Changes729/Hands-clothes/README.md

KHub 黑客松 3D 打印手部护具赛题成果

- 赛题项目：https://github.com/Amasun93/open-hand-aid
- 黑客松总结：[KHub 黑客松总结](./doc/hackthon/KHub手部辅具说明.md)

许多资料都在社区里，不适合放入 Github 代码仓库。如果有兴趣请联系 Khub 官方了解更多信息。

工程使用 FreeCAD 进行设计。
