Changes729/Hands-clothes/doc/understand/对比图A.jpg

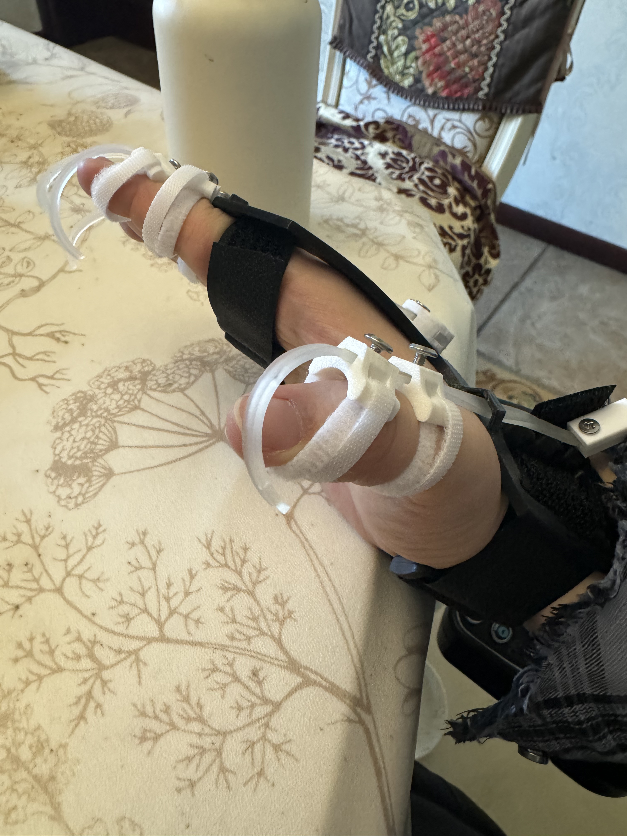
doc/understand/对比图A.jpg
