Changes729/Hands-clothes/doc/understand/对比图B.jpg

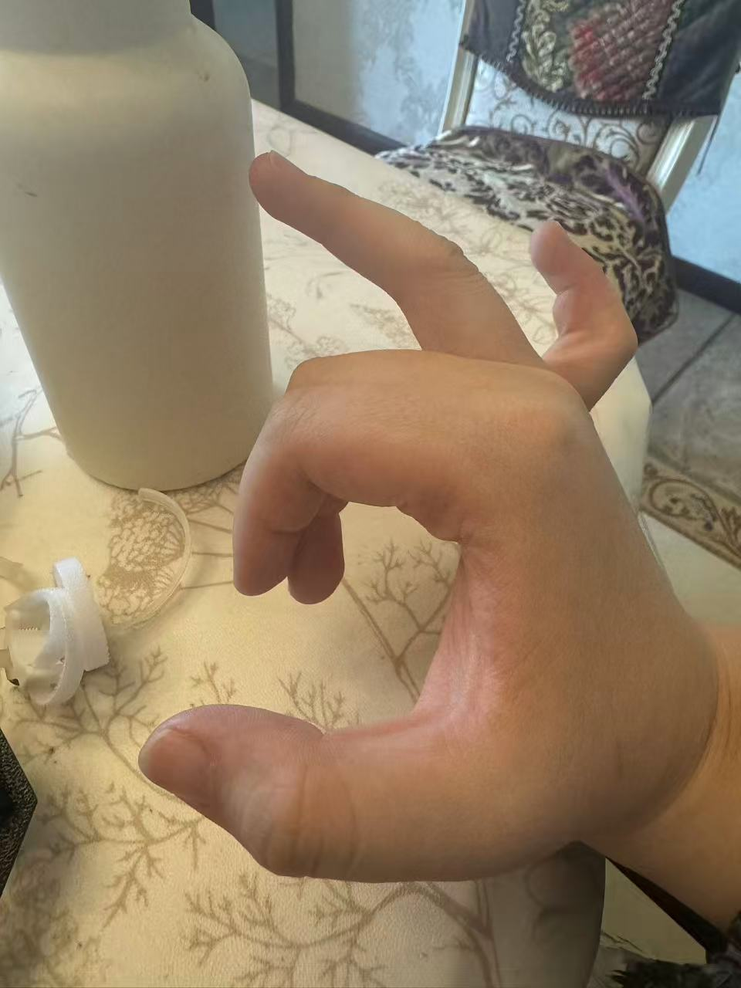
doc/understand/对比图B.jpg
