Changes729/Hands-clothes/doc/understand/结构图2.jpg

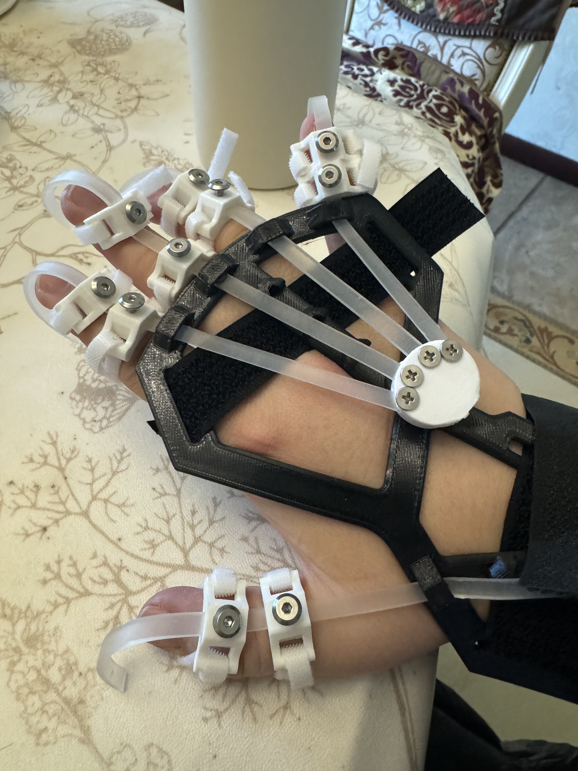
doc/understand/结构图2.jpg
