Changes729/Hands-clothes/doc/understand/结构图.jpg

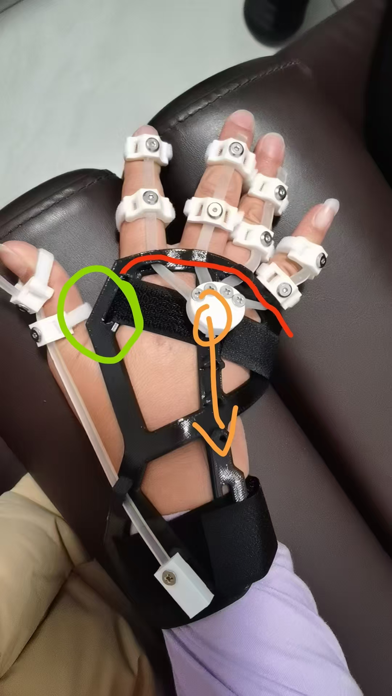
doc/understand/结构图.jpg
