Changes729/Hands-clothes/doc/understand/需求说明2.png

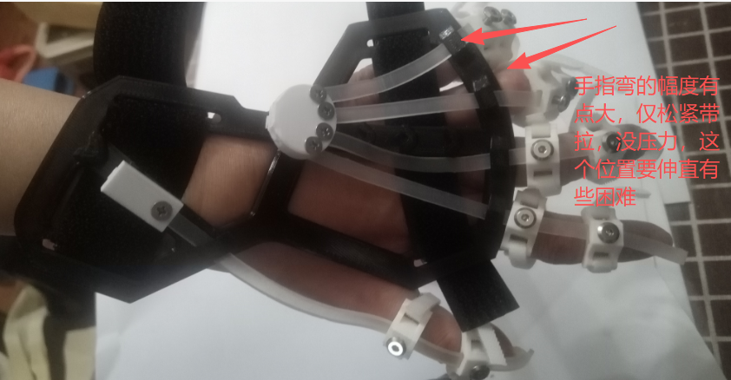
doc/understand/需求说明2.png
