Changes729/Hands-clothes/doc/understand/需求说明.png

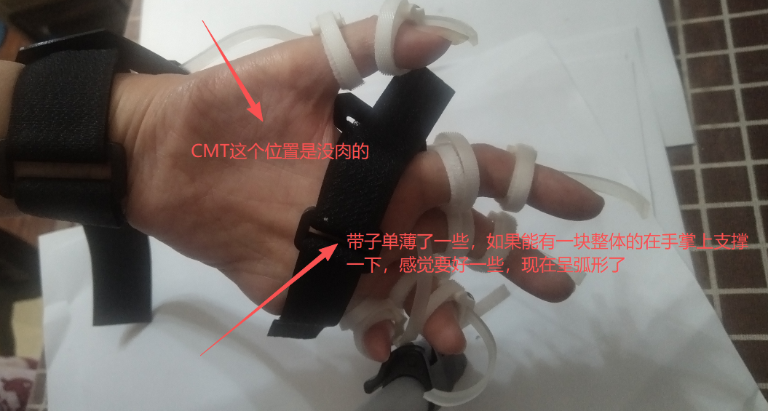
doc/understand/需求说明.png
