Changes729/Hands-clothes/hackthon.FCStd

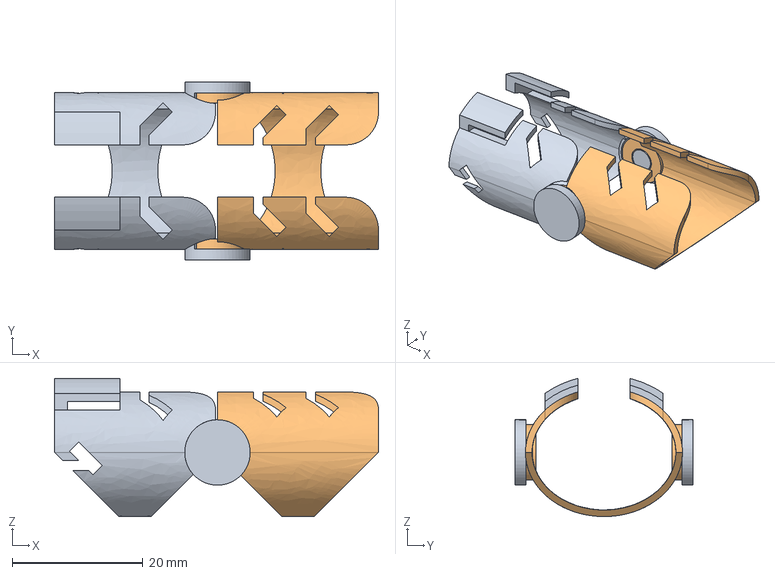
[picture p20: CAD file, 2026-10-18]
hackthon.FCStd
49.5 x 27.2 x 21.1 mm
扳指C
扳指C-P
